MicrochipSecurityFG/Class_HackingTheBadge_2025/hw/KiCad_badge/Project KiCAD/Keystone/596.step

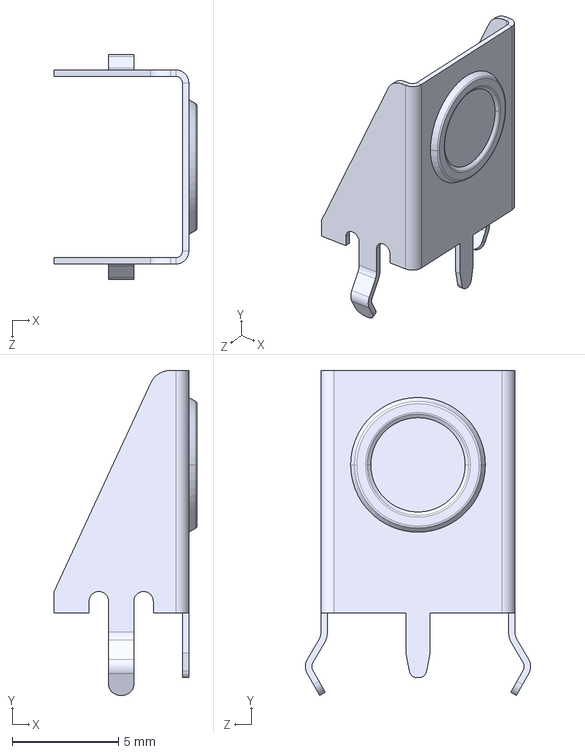
[picture p1: CAD file, 2025-06-12]
hw/KiCad_badge/Project KiCAD/Keystone/596.step
6.73 x 15.3 x 10.6 mm
