MicrochipSecurityFG/Class_HackingTheBadge_2025/hw/KiCad_badge/Project KiCAD/Keystone/590--3DModel-STEP-630548.STEP

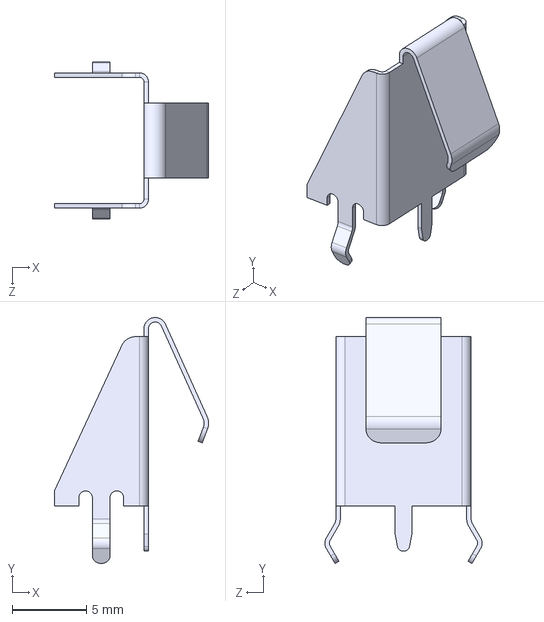
[picture p2: CAD file, 2025-06-12]
hw/KiCad_badge/Project KiCAD/Keystone/590--3DModel-STEP-630548.STEP
10.4 x 16.6 x 10.6 mm
