MicrochipSecurityFG/Class_HackingTheBadge_2025/hw/KiCad_badge/Project KiCAD/misc/USB4105-GF-A.step

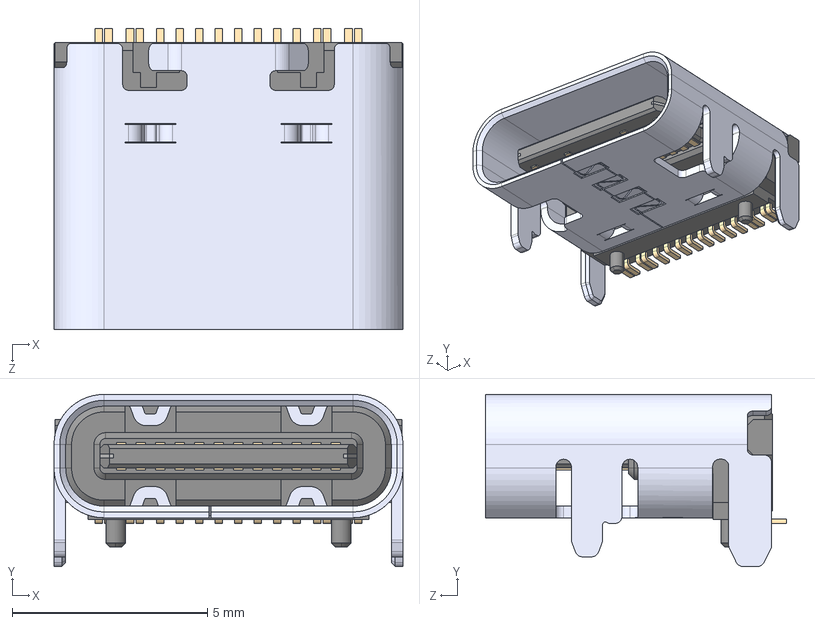
[picture p3: CAD file, 2025-06-12]
hw/KiCad_badge/Project KiCAD/misc/USB4105-GF-A.step
8.94 x 4.41 x 7.71 mm
