MicrochipSecurityFG/Class_HackingTheBadge_2025/hw/KiCad_badge/Project KiCAD/misc/RM100--3DModel-STEP-56544.STEP

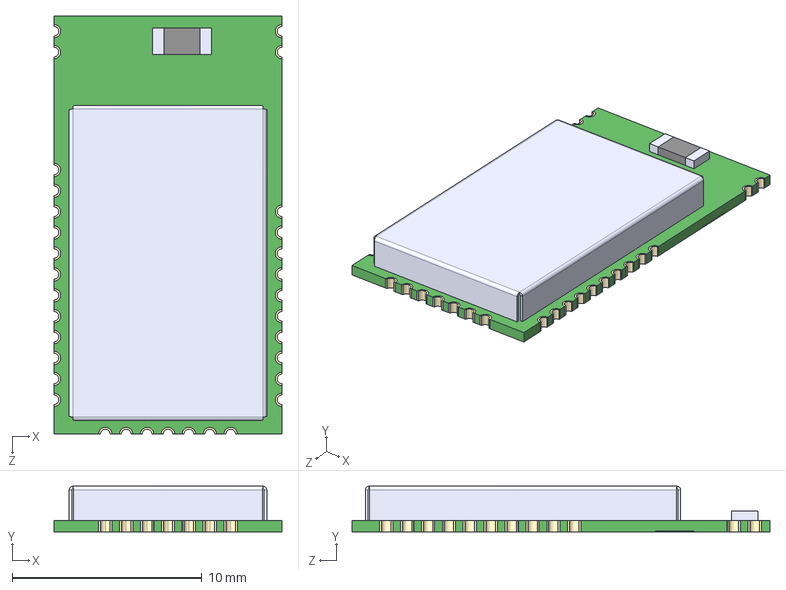
[picture p4: CAD file, 2025-06-12]
hw/KiCad_badge/Project KiCAD/misc/RM100--3DModel-STEP-56544.STEP
12.0 x 2.40 x 22.0 mm
