MicrochipSecurityFG/Class_HackingTheBadge_2025/hw/KiCad_badge/Project KiCAD/misc/AAA Battery.stp

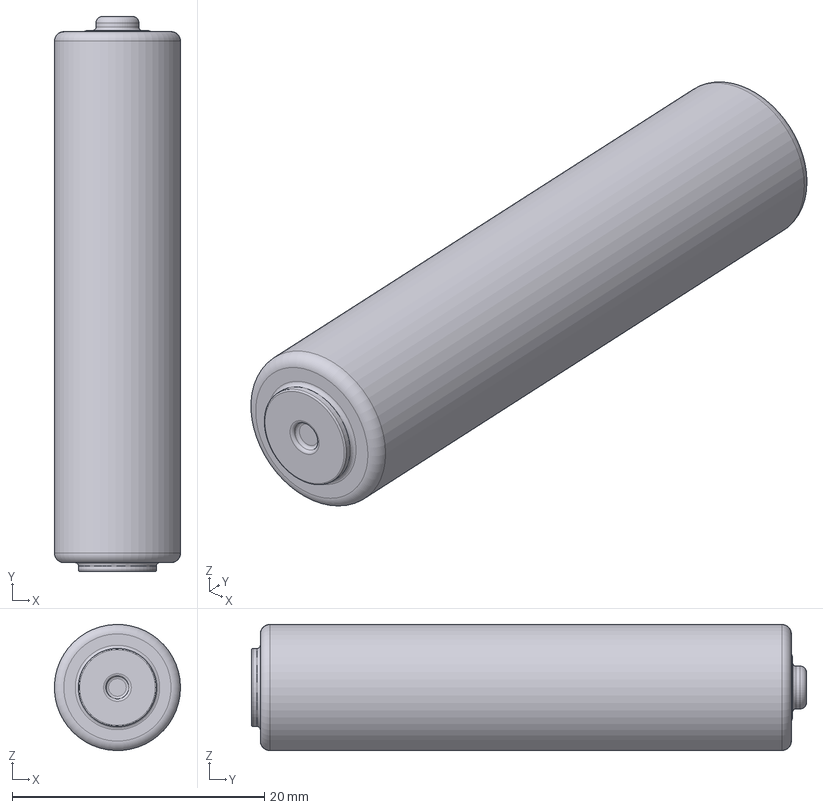
[picture p5: CAD file, 2025-06-12]
hw/KiCad_badge/Project KiCAD/misc/AAA Battery.stp
9.99 x 44.0 x 10.00 mm
