MicrochipSecurityFG/Class_HackingTheBadge_2025/hw/KiCad_badge/Project KiCAD/misc/47571-0001-with-sdcard.STEP

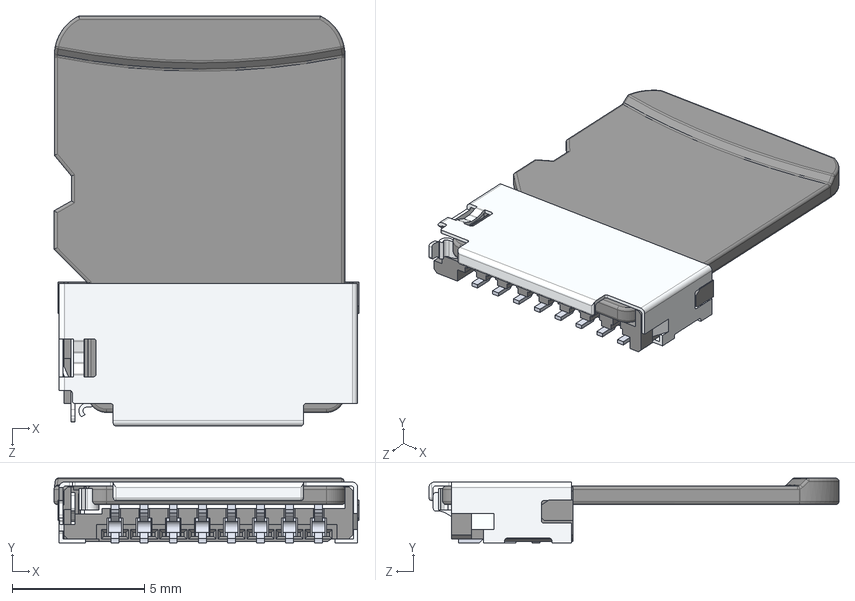
[picture p6: CAD file, 2025-06-12]
hw/KiCad_badge/Project KiCAD/misc/47571-0001-with-sdcard.STEP
11.5 x 2.45 x 15.5 mm
microsd
