MicrochipSecurityFG/Class_HackingTheBadge_2025/hw/KiCad_badge/Project KiCAD/misc/47571-0001.STEP

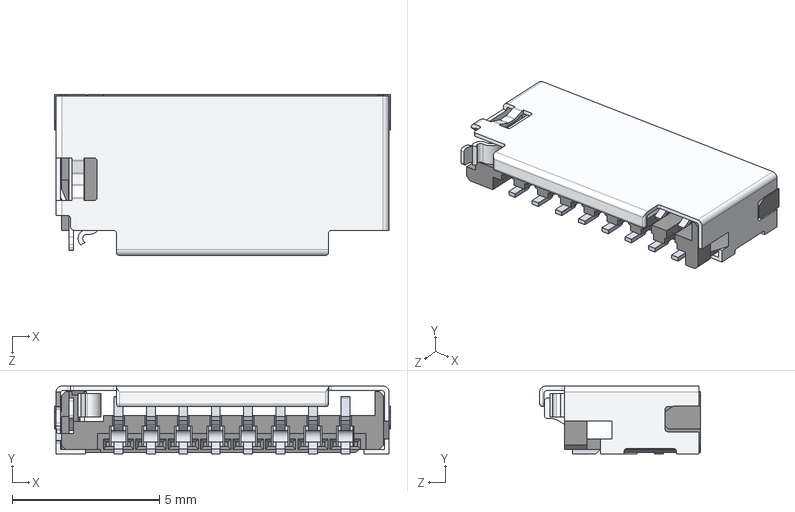
[picture p7: CAD file, 2025-06-12]
hw/KiCad_badge/Project KiCAD/misc/47571-0001.STEP
11.4 x 2.30 x 5.45 mm
