MicrochipSecurityFG/Class_HackingTheBadge_2025/doc/schematic.pdf

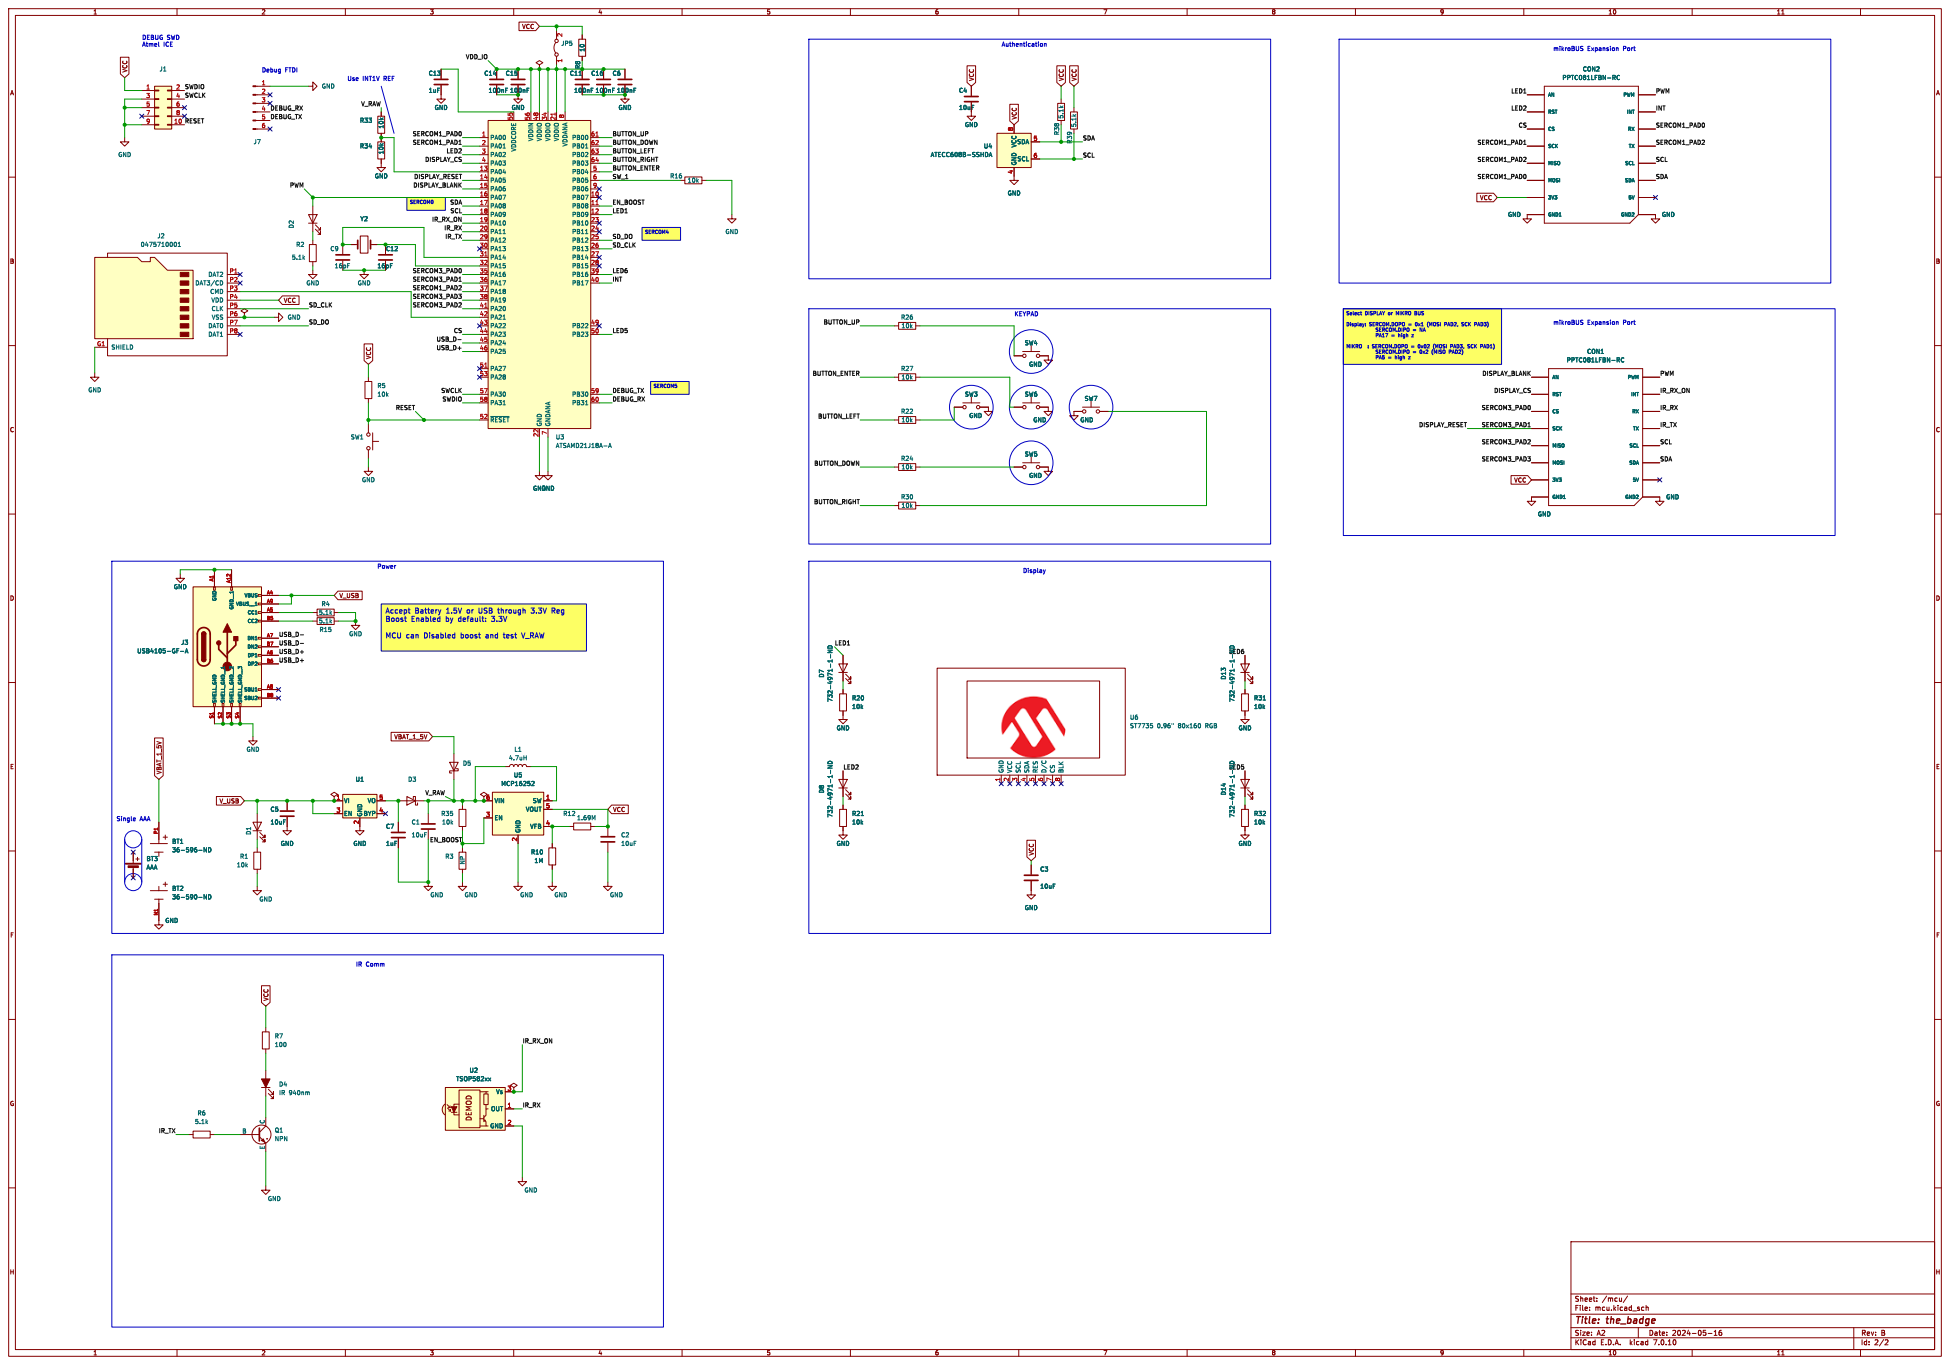
[picture p8: page 1]

mikroBUS Expansion Port KEYPAD

File: mcu.kicad_sch Sheet: /mcu/ 1

10k GND GND GND GND
