MicrochipSecurityFG/Class_HackingTheBadge_2025/sw/pc/TERATERM.INI

[Tera Term]
Version=4.106
Language=English
Port=serial
TerminalSize=113,61
TermIsWin=on
AutoWinResize=off
CRReceive=LF
CRSend=LF
LocalEcho=on
Answerback=
KanjiReceive=SJIS
KatakanaReceive=8
KanjiSend=SJIS
KatakanaSend=8
KanjiIn=B
KanjiOut=J
ConnectingTimeout=0
DisablePasteMouseRButton=off
DisablePasteMouseMButton=on
ConfirmPasteMouseRButton=off
ConfirmChangePaste=on
ConfirmChangePasteCR=on
ConfirmChangePasteStringFile=
ScrollWindowClearScreen=on
SelectOnlyByLButton=on
DisableAcceleratorSendBreak=off
EnableContinuedLineCopy=on
MouseCursor=IBEAM
AlphaBlend=255
AlphaBlendActive=255
CygwinDirectory=c:\cygwin
ViewlogEditor=C:\windows\notepad.exe
Locale=japanese
ANSIColor=0,0,0,0, 1,255,0,0, 2,0,255,0, 3,255,255,0, 4,0,0,255, 5,255,0,255, 6,0,255,255, 7,255,255,255, 8,128,128,128, 9,128,0,0, 10,0,128,0, 11,128,128,0, 12,0,0,128, 13,128,0,128, 14,0,128,128, 15,192,192,192
AutoWinSwitch=off
TerminalID=VT100
RussHost=KOI8-R
RussClient=Windows
Title=Tera Term
CursorShape=block
HideTitle=off
PopupMenu=off
PcBoldColor=off
Aixterm16Color=off
Xterm256Color=on
EnableScrollBuff=on
ScrollBuffSize=1000
VTColor=255,255,255,0,0,0
VTBoldColor=0,0,255,255,255,255
VTBlinkColor=255,0,0,255,255,255
VTReverseColor=255,255,255,0,0,0
EnableClickableUrl=off
URLColor=0,255,0,255,255,255
EnableBoldAttrColor=on
EnableBlinkAttrColor=on
EnableReverseAttrColor=off
EnableURLColor=on
URLUnderline=on
EnableANSIColor=on
TEKColor=0,0,0,255,255,255
TEKColorEmulation=off
VTFont=Terminal,0,-13,1
EnableBold=on
RussFont=Windows
TEKFont=Courier,0,-13,0
BSKey=BS
DeleteKey=off
Metakey=off
DisableAppKeypad=off
DisableAppCursor=off
RussKeyb=Windows
ComPort=3
BaudRate=115200
Parity=none
DataBit=8
StopBit=1
FlowCtrl=none
DelayPerChar=0
DelayPerLine=0
Telnet=on
TermType=xterm
TCPPort=23
AutoWinClose=on
Historylist=off
TransBin=off
LogBinary=off
LogAppend=off
LogTypePlainText=off
LogTimestamp=off
LogHideDialog=off
LogIncludeScreenBuffer=off
LogTimestampFormat=%Y-%m-%d %H:%M:%S.%N
LogTimestampType=Local
LogDefaultName=teraterm.log
LogDefaultPath=
LogAutoStart=off
LogRotate=0
LogRotateSize=0
LogRotateSizeType=0
LogRotateStep=0
DeferredLogWriteMode=on
XmodemOpt=checksum
XmodemBin=on
XmodemRcvCommand=
FileDir=C:\Users\c40249\Downloads
FileSendFilter=
ScpSendDir=
Accept8BitCtrl=on
AllowWrongSequence=off
AutoComPortReconnect=on
AutoFileRename=off
AutoTextCopy=on
BackWrap=off
Beep=on
BeepOnConnect=off
BPAuto=off
BPEscCtl=off
BPLog=off
ClearComBuffOnOpen=on
WaitCom=off
ConfirmDisconnect=on
CtrlInKanji=on
Debug=off
DelimList=$20!"#$24%&'()*+,-./:;<=>?@[\]^`{|}~
DelimDBCS=on
EnablePopupMenu=on
EnableShowMenu=on
EnableStatusLine=on
FileSendHighSpeedMode=on
IME=on
IMEInline=on
KmtLog=off
KmtLongPacket=off
KmtFileAttr=off
LanguageSelection=on
MaxBuffSize=10000
MaxComPort=256
NonblinkingCursor=off
KillFocusCursor=on
PassThruDelay=3
PassThruPort=
PrinterCtrlSequence=on
PrnFont=
PrnMargin=50,50,50,50
PrnConvFF=off
QVLog=off
QVWinSize=8
RussPrint=Windows
ScrollThreshold=12
MouseWheelScrollLine=3
SelectOnActivate=on
Send8BitCtrl=off
SendBreakTime=1000
StartupMacro=
TEKGINMouseCode=32
TelAutoDetect=on
TelBin=off
TelEcho=off
TelLog=off
TelPort=23
TelKeepAliveInterval=300
MaxBroadcatHistory=99
TCPLocalEcho=off
TCPCRSend=
UseTextColor=off
TitleFormat=13
VTCompatTab=off
VTFontSpace=0,0,0,0
VTPPI=0,0
TEKPPI=0,0
WindowMenu=on
XmodemLog=off
YmodemLog=off
YmodemRcvCommand=rb
ZmodemAuto=off
ZmodemDataLen=1024
ZmodemWinSize=32767
ZmodemEscCtl=off
ZmodemLog=off
ZmodemRcvCommand=rz
UseNormalBGColor=off
UILanguageFile=lang\Default.lng
BroadcastCommandHistory=off
AcceptBroadcast=on
ConfirmFileDragAndDrop=on
TranslateWheelToCursor=on
HostDialogOnStartup=on
MouseEventTracking=on
MaximizedBugTweak=2
UnicodeToDecSpMapping=3
AutoScrollOnlyInBottomLine=off
UnknownUnicodeCharacterAsWide=off
AcceptTitleChangeRequest=overwrite
PasteDialogSize=448,303
DisableMouseTrackingByCtrl=on
DisableWheelToCursorByCtrl=on
StrictKeyMapping=off
Wait4allMacroCommand=off
DisableMenuSendBreak=off
ClearScreenOnCloseConnection=off
DisableAcceleratorDuplicateSession=off
AcceleratorNewConnection=on
AcceleratorCygwinConnection=on
DisableMenuDuplicateSession=off
DisableMenuNewConnection=off
PasteDelayPerLine=10
Meta8Bit=off
WindowCtrlSequence=on
CursorCtrlSequence=off
WindowReportSequence=on
TitleReportSequence=empty
EnableLineMode=on
ClearOnResize=on
AlternateScreenBuffer=on
IMERelatedCursor=off
TerminalUID=FFFFFFFF
LockTUID=on
JumpList=on
TabStopModifySequence=on
ClipboardAccessFromRemote=off
NotifyClipboardAccess=on
ClickableUrlBrowser=
ClickableUrlBrowserArg=
LogLockExclusive=on
FontQuality=default
BeepOverUsedCount=5
BeepOverUsedTime=2
BeepSuppressTime=5
MaxOSCBufferSize=4096
JoinSplitURL=off
JoinSplitURLIgnoreEOLChar=\
DebugModes=all
XmodemTimeouts=10,3,10,20,60
YmodemTimeouts=10,3,10,20,60
ZmodemTimeouts=10,0,10,3
TrimTrailingNLonPaste=on
NormalizeLineBreakOnPaste=off
ListHiddenFonts=off
ISO2022ShiftFunction=on
TerminalSpeed=38400
ClearScrollBufferFromRemote=off
MouseSelectStartDelay=0
DlgFont=,0,0
[BG]
BGEnable=off
BGUseAlphaBlendAPI=on
BGSPIPath=plugin
BGFastSizeMove=on
BGFlickerlessMove=on
BGNoFrame=off
BGThemeFile=
BGIgnoreThemeFile=off
[TTSSH]
Enabled=0
Compression=0
DefaultUserType=1
DefaultUserName=
DefaultForwarding=
CipherOrder=MKN>H:J=G9LI<F8C7D;EB30A@?62
KexOrder=567:9843210
HostKeyOrder=4567230
MacOrder=@?:861>5;20<=34
CompOrder=3210
KnownHostsFiles=ssh_known_hosts
DefaultRhostsLocalUserName=
DefaultRhostsHostPrivateKeyFile=
DefaultRSAPrivateKeyFile=
DefaultAuthMethod=3
LogLevel=0
WriteBufferSize=2097152
ProtocolVersion=2
HeartBeat=60
RememberPassword=1
CheckAuthListFirst=0
EnableRsaShortKeyServer=0
ForwardAgent=0
ForwardAgentConfirm=1
ForwardAgentNotify=1
VerifyHostKeyDNS=1
SSHIcon=Default
DisablePopupMessage=0
X11Display=
UpdateHostkeys=0
GexMinimalGroupSize=0
AuthBanner=1
[TTProxy]
ConnectionTimeout="10"
SocksResolve="auto"
TelnetHostnamePrompt=">> Host name: "
TelnetUsernamePrompt="Username:"
TelnetPasswordPrompt="Password:"
TelnetConnectedMessage="-- Connected to "
TelnetErrorMessage="!!!!!!!!"
[Hosts]
Host1=192.168.1.20
