MicrochipSecurityFG/Class_HackingTheBadge_2025/sw/wallet_firmware/firmware/src/config/default/configuration.h

/*******************************************************************************
  System Configuration Header

  File Name:
    configuration.h

  Summary:
    Build-time configuration header for the system defined by this project.

  Description:
    An MPLAB Project may have multiple configurations.  This file defines the
    build-time options for a single configuration.

  Remarks:
    This configuration header must not define any prototypes or data
    definitions (or include any files that do).  It only provides macro
    definitions for build-time configuration options

*******************************************************************************/

// DOM-IGNORE-BEGIN
/*******************************************************************************
* Copyright (C) 2018 Microchip Technology Inc. and its subsidiaries.
*
* Subject to your compliance with these terms, you may use Microchip software
* and any derivatives exclusively with Microchip products. It is your
* responsibility to comply with third party license terms applicable to your
* use of third party software (including open source software) that may
* accompany Microchip software.
*
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
* IN NO EVENT WILL MICROCHIP BE LIABLE FOR ANY INDIRECT, SPECIAL, PUNITIVE,
* INCIDENTAL OR CONSEQUENTIAL LOSS, DAMAGE, COST OR EXPENSE OF ANY KIND
* WHATSOEVER RELATED TO THE SOFTWARE, HOWEVER CAUSED, EVEN IF MICROCHIP HAS
* BEEN ADVISED OF THE POSSIBILITY OR THE DAMAGES ARE FORESEEABLE. TO THE
* FULLEST EXTENT ALLOWED BY LAW, MICROCHIP'S TOTAL LIABILITY ON ALL CLAIMS IN
* ANY WAY RELATED TO THIS SOFTWARE WILL NOT EXCEED THE AMOUNT OF FEES, IF ANY,
* THAT YOU HAVE PAID DIRECTLY TO MICROCHIP FOR THIS SOFTWARE.
*******************************************************************************/
// DOM-IGNORE-END

#ifndef CONFIGURATION_H
#define CONFIGURATION_H

// *****************************************************************************
// *****************************************************************************
// Section: Included Files
// *****************************************************************************
// *****************************************************************************
/*  This section Includes other configuration headers necessary to completely
    define this configuration.
*/

#include "user.h"
#include "device.h"

// DOM-IGNORE-BEGIN
#ifdef __cplusplus  // Provide C++ Compatibility

extern "C" {

#endif
// DOM-IGNORE-END

// *****************************************************************************
// *****************************************************************************
// Section: System Configuration
// *****************************************************************************
// *****************************************************************************



// *****************************************************************************
// *****************************************************************************
// Section: System Service Configuration
// *****************************************************************************
// *****************************************************************************
/* TIME System Service Configuration Options */
#define SYS_TIME_INDEX_0                            (0)
#define SYS_TIME_MAX_TIMERS                         (5)
#define SYS_TIME_HW_COUNTER_WIDTH                   (16)
#define SYS_TIME_HW_COUNTER_PERIOD                  (0xFFFFU)
#define SYS_TIME_HW_COUNTER_HALF_PERIOD             (SYS_TIME_HW_COUNTER_PERIOD>>1)
#define SYS_TIME_CPU_CLOCK_FREQUENCY                (48000000)
#define SYS_TIME_COMPARE_UPDATE_EXECUTION_CYCLES    (200)



// *****************************************************************************
// *****************************************************************************
// Section: Driver Configuration
// *****************************************************************************
// *****************************************************************************
/* SPI Driver Common Configuration Options */
#define DRV_SPI_INSTANCES_NUMBER              (1U)

/* SPI Driver Instance 0 Configuration Options */
#define DRV_SPI_INDEX_0                       0
#define DRV_SPI_CLIENTS_NUMBER_IDX0           1
#define DRV_SPI_QUEUE_SIZE_IDX0               8



// *****************************************************************************
// *****************************************************************************
// Section: Middleware & Other Library Configuration
// *****************************************************************************
// *****************************************************************************


// *****************************************************************************
// *****************************************************************************
// Section: Application Configuration
// *****************************************************************************
// *****************************************************************************


//DOM-IGNORE-BEGIN
#ifdef __cplusplus
}
#endif
//DOM-IGNORE-END

#endif // CONFIGURATION_H
/*******************************************************************************
 End of File
*/
