MicrochipSecurityFG/Class_HackingTheBadge_2025/sw/wallet_firmware/firmware/src/config/default/initialization.c

/*******************************************************************************
  System Initialization File

  File Name:
    initialization.c

  Summary:
    This file contains source code necessary to initialize the system.

  Description:
    This file contains source code necessary to initialize the system.  It
    implements the "SYS_Initialize" function, defines the configuration bits,
    and allocates any necessary global system resources,
 *******************************************************************************/

// DOM-IGNORE-BEGIN
/*******************************************************************************
* Copyright (C) 2018 Microchip Technology Inc. and its subsidiaries.
*
* Subject to your compliance with these terms, you may use Microchip software
* and any derivatives exclusively with Microchip products. It is your
* responsibility to comply with third party license terms applicable to your
* use of third party software (including open source software) that may
* accompany Microchip software.
*
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
* IN NO EVENT WILL MICROCHIP BE LIABLE FOR ANY INDIRECT, SPECIAL, PUNITIVE,
* INCIDENTAL OR CONSEQUENTIAL LOSS, DAMAGE, COST OR EXPENSE OF ANY KIND
* WHATSOEVER RELATED TO THE SOFTWARE, HOWEVER CAUSED, EVEN IF MICROCHIP HAS
* BEEN ADVISED OF THE POSSIBILITY OR THE DAMAGES ARE FORESEEABLE. TO THE
* FULLEST EXTENT ALLOWED BY LAW, MICROCHIP'S TOTAL LIABILITY ON ALL CLAIMS IN
* ANY WAY RELATED TO THIS SOFTWARE WILL NOT EXCEED THE AMOUNT OF FEES, IF ANY,
* THAT YOU HAVE PAID DIRECTLY TO MICROCHIP FOR THIS SOFTWARE.
 *******************************************************************************/
// DOM-IGNORE-END

// *****************************************************************************
// *****************************************************************************
// Section: Included Files
// *****************************************************************************
// *****************************************************************************
#include "configuration.h"
#include "definitions.h"
#include "device.h"


// ****************************************************************************
// ****************************************************************************
// Section: Configuration Bits
// ****************************************************************************
// ****************************************************************************
#pragma config NVMCTRL_BOOTPROT = SIZE_0BYTES
#pragma config NVMCTRL_EEPROM_SIZE = SIZE_0BYTES
#pragma config BOD33USERLEVEL = 0x7U // Enter Hexadecimal value
#pragma config BOD33_EN = ENABLED
#pragma config BOD33_ACTION = RESET

#pragma config BOD33_HYST = DISABLED
#pragma config NVMCTRL_REGION_LOCKS = 0xffffU // Enter Hexadecimal value

#pragma config WDT_ENABLE = DISABLED
#pragma config WDT_ALWAYSON = DISABLED
#pragma config WDT_PER = CYC16384

#pragma config WDT_WINDOW_0 = SET
#pragma config WDT_WINDOW_1 = 0x4U // Enter Hexadecimal value
#pragma config WDT_EWOFFSET = CYC16384
#pragma config WDT_WEN = DISABLED




// *****************************************************************************
// *****************************************************************************
// Section: Driver Initialization Data
// *****************************************************************************
// *****************************************************************************
/* Following MISRA-C rules are deviated in the below code block */
/* MISRA C-2012 Rule 11.1 */
/* MISRA C-2012 Rule 11.3 */
/* MISRA C-2012 Rule 11.8 */
// <editor-fold defaultstate="collapsed" desc="DRV_SPI Instance 0 Initialization Data">

/* SPI Client Objects Pool */
static DRV_SPI_CLIENT_OBJ drvSPI0ClientObjPool[DRV_SPI_CLIENTS_NUMBER_IDX0];

/* SPI Transfer Objects Pool */
static DRV_SPI_TRANSFER_OBJ drvSPI0TransferObjPool[DRV_SPI_QUEUE_SIZE_IDX0];

/* SPI PLIB Interface Initialization */
static const DRV_SPI_PLIB_INTERFACE drvSPI0PlibAPI = {

    /* SPI PLIB Setup */
    .setup = (DRV_SPI_PLIB_SETUP)SERCOM3_SPI_TransferSetup,

    /* SPI PLIB WriteRead function */
    .writeRead = (DRV_SPI_PLIB_WRITE_READ)SERCOM3_SPI_WriteRead,

    /* SPI PLIB Transfer Status function */
    .isTransmitterBusy = (DRV_SPI_PLIB_TRANSMITTER_IS_BUSY)SERCOM3_SPI_IsTransmitterBusy,

    /* SPI PLIB Callback Register */
    .callbackRegister = (DRV_SPI_PLIB_CALLBACK_REGISTER)SERCOM3_SPI_CallbackRegister,
};

static const uint32_t drvSPI0remapDataBits[]= { 0x0, 0x1, 0xFFFFFFFFU, 0xFFFFFFFFU, 0xFFFFFFFFU, 0xFFFFFFFFU, 0xFFFFFFFFU, 0xFFFFFFFFU, 0xFFFFFFFFU, 0xFFFFFFFFU };
static const uint32_t drvSPI0remapClockPolarity[] = { 0x0, 0x20000000 };
static const uint32_t drvSPI0remapClockPhase[] = { 0x10000000, 0x0 };

static const DRV_SPI_INTERRUPT_SOURCES drvSPI0InterruptSources =
{
    /* Peripheral has single interrupt vector */
    .isSingleIntSrc                        = true,

    /* Peripheral interrupt line */
    .intSources.spiInterrupt             = (int32_t)SERCOM3_IRQn,
};

/* SPI Driver Initialization Data */
static const DRV_SPI_INIT drvSPI0InitData =
{
    /* SPI PLIB API */
    .spiPlib = &drvSPI0PlibAPI,

    .remapDataBits = drvSPI0remapDataBits,

    .remapClockPolarity = drvSPI0remapClockPolarity,

    .remapClockPhase = drvSPI0remapClockPhase,

    /* SPI Number of clients */
    .numClients = DRV_SPI_CLIENTS_NUMBER_IDX0,

    /* SPI Client Objects Pool */
    .clientObjPool = (uintptr_t)&drvSPI0ClientObjPool[0],


    /* SPI Queue Size */
    .transferObjPoolSize = DRV_SPI_QUEUE_SIZE_IDX0,

    /* SPI Transfer Objects Pool */
    .transferObjPool = (uintptr_t)&drvSPI0TransferObjPool[0],

    /* SPI interrupt sources (SPI peripheral and DMA) */
    .interruptSources = &drvSPI0InterruptSources,
};
// </editor-fold>



// *****************************************************************************
// *****************************************************************************
// Section: System Data
// *****************************************************************************
// *****************************************************************************
/* Structure to hold the object handles for the modules in the system. */
SYSTEM_OBJECTS sysObj;

// *****************************************************************************
// *****************************************************************************
// Section: Library/Stack Initialization Data
// *****************************************************************************
// *****************************************************************************


// *****************************************************************************
// *****************************************************************************
// Section: System Initialization
// *****************************************************************************
// *****************************************************************************
// <editor-fold defaultstate="collapsed" desc="SYS_TIME Initialization Data">

static const SYS_TIME_PLIB_INTERFACE sysTimePlibAPI = {
    .timerCallbackSet = (SYS_TIME_PLIB_CALLBACK_REGISTER)TC3_TimerCallbackRegister,
    .timerStart = (SYS_TIME_PLIB_START)TC3_TimerStart,
    .timerStop = (SYS_TIME_PLIB_STOP)TC3_TimerStop,
    .timerFrequencyGet = (SYS_TIME_PLIB_FREQUENCY_GET)TC3_TimerFrequencyGet,
    .timerPeriodSet = (SYS_TIME_PLIB_PERIOD_SET)TC3_Timer16bitPeriodSet,
    .timerCompareSet = (SYS_TIME_PLIB_COMPARE_SET)TC3_Timer16bitCompareSet,
    .timerCounterGet = (SYS_TIME_PLIB_COUNTER_GET)TC3_Timer16bitCounterGet,
};

static const SYS_TIME_INIT sysTimeInitData =
{
    .timePlib = &sysTimePlibAPI,
    .hwTimerIntNum = TC3_IRQn,
};

// </editor-fold>



// *****************************************************************************
// *****************************************************************************
// Section: Local initialization functions
// *****************************************************************************
// *****************************************************************************


/* MISRAC 2012 deviation block end */

/*******************************************************************************
  Function:
    void SYS_Initialize ( void *data )

  Summary:
    Initializes the board, services, drivers, application and other modules.

  Remarks:
 */

void SYS_Initialize ( void* data )
{

    /* MISRAC 2012 deviation block start */
    /* MISRA C-2012 Rule 2.2 deviated in this file.  Deviation record ID -  H3_MISRAC_2012_R_2_2_DR_1 */

    NVMCTRL_REGS->NVMCTRL_CTRLB = NVMCTRL_CTRLB_RWS(3UL);


  
    PORT_Initialize();

    CLOCK_Initialize();




    NVMCTRL_Initialize( );

    TC3_TimerInitialize();

    TC4_TimerInitialize();

    SERCOM3_SPI_Initialize();

    SERCOM2_USART_Initialize();


    SERCOM0_I2C_Initialize();

	SYSTICK_TimerInitialize();
    SERCOM5_USART_Initialize();

    EIC_Initialize();

    TCC2_PWMInitialize();



    /* MISRAC 2012 deviation block start */
    /* Following MISRA-C rules deviated in this block  */
    /* MISRA C-2012 Rule 11.3 - Deviation record ID - H3_MISRAC_2012_R_11_3_DR_1 */
    /* MISRA C-2012 Rule 11.8 - Deviation record ID - H3_MISRAC_2012_R_11_8_DR_1 */

    /* Initialize SPI0 Driver Instance */
    sysObj.drvSPI0 = DRV_SPI_Initialize(DRV_SPI_INDEX_0, (SYS_MODULE_INIT *)&drvSPI0InitData);

    DRV_ST7735S_Initialize();


    /* MISRA C-2012 Rule 11.3, 11.8 deviated below. Deviation record ID -  
    H3_MISRAC_2012_R_11_3_DR_1 & H3_MISRAC_2012_R_11_8_DR_1*/
        
    sysObj.sysTime = SYS_TIME_Initialize(SYS_TIME_INDEX_0, (SYS_MODULE_INIT *)&sysTimeInitData);
    
    /* MISRAC 2012 deviation block end */

    // initialize UI library
    Legato_Initialize();


    /* MISRAC 2012 deviation block end */
    APP_Initialize();


    NVIC_Initialize();


    /* MISRAC 2012 deviation block end */
}

/*******************************************************************************
 End of File
*/
