MicrochipSecurityFG/Class_HackingTheBadge_2025/sw/wallet_firmware/firmware/src/config/default/peripheral/eic/plib_eic.c

/*******************************************************************************
  External Interrupt Controller (EIC) PLIB

  Company
    Microchip Technology Inc.

  File Name
    plib_eic.c

  Summary
    Source for EIC peripheral library interface Implementation.

  Description
    This file defines the interface to the EIC peripheral library. This
    library provides access to and control of the associated peripheral
    instance.

  Remarks:
    None.

*******************************************************************************/

// DOM-IGNORE-BEGIN
/*******************************************************************************
* Copyright (C) 2018 Microchip Technology Inc. and its subsidiaries.
*
* Subject to your compliance with these terms, you may use Microchip software
* and any derivatives exclusively with Microchip products. It is your
* responsibility to comply with third party license terms applicable to your
* use of third party software (including open source software) that may
* accompany Microchip software.
*
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
* IN NO EVENT WILL MICROCHIP BE LIABLE FOR ANY INDIRECT, SPECIAL, PUNITIVE,
* INCIDENTAL OR CONSEQUENTIAL LOSS, DAMAGE, COST OR EXPENSE OF ANY KIND
* WHATSOEVER RELATED TO THE SOFTWARE, HOWEVER CAUSED, EVEN IF MICROCHIP HAS
* BEEN ADVISED OF THE POSSIBILITY OR THE DAMAGES ARE FORESEEABLE. TO THE
* FULLEST EXTENT ALLOWED BY LAW, MICROCHIP'S TOTAL LIABILITY ON ALL CLAIMS IN
* ANY WAY RELATED TO THIS SOFTWARE WILL NOT EXCEED THE AMOUNT OF FEES, IF ANY,
* THAT YOU HAVE PAID DIRECTLY TO MICROCHIP FOR THIS SOFTWARE.
*******************************************************************************/
// DOM-IGNORE-END

// *****************************************************************************
// *****************************************************************************
// Section: Included Files
// *****************************************************************************
// *****************************************************************************
/* This section lists the other files that are included in this file.
*/

#include "plib_eic.h"
#include "interrupts.h"

// *****************************************************************************
// *****************************************************************************
// Section: Global Data
// *****************************************************************************
// *****************************************************************************
/* EIC Channel Callback object */
volatile static EIC_CALLBACK_OBJ    eicCallbackObject[EXTINT_COUNT];


void EIC_Initialize(void)
{
    /* Reset all registers in the EIC module to their initial state and
       EIC will be disabled. */
    EIC_REGS->EIC_CTRL |= EIC_CTRL_SWRST_Msk;

    while((EIC_REGS->EIC_STATUS & EIC_STATUS_SYNCBUSY_Msk) == EIC_STATUS_SYNCBUSY_Msk)
    {
        /* Wait for sync */
    }

    /* NMI Control register */

    /* Interrupt sense type and filter control for EXTINT channels 0 to 7 */
    EIC_REGS->EIC_CONFIG[0] = EIC_CONFIG_SENSE0_FALL | EIC_CONFIG_FILTEN0_Msk |
                              EIC_CONFIG_SENSE1_FALL | EIC_CONFIG_FILTEN1_Msk |
                              EIC_CONFIG_SENSE2_FALL | EIC_CONFIG_FILTEN2_Msk |
                              EIC_CONFIG_SENSE3_FALL | EIC_CONFIG_FILTEN3_Msk |
                              EIC_CONFIG_SENSE4_FALL | EIC_CONFIG_FILTEN4_Msk |
                              EIC_CONFIG_SENSE5_NONE  |
                              EIC_CONFIG_SENSE6_NONE  |
                              EIC_CONFIG_SENSE7_NONE ;

    /* Interrupt sense type and filter control for EXTINT channels 8 to 15 */
    EIC_REGS->EIC_CONFIG[1] = EIC_CONFIG_SENSE0_NONE  |
                              EIC_CONFIG_SENSE1_NONE  |
                              EIC_CONFIG_SENSE2_NONE  |
                              EIC_CONFIG_SENSE3_NONE  |
                              EIC_CONFIG_SENSE4_NONE  |
                              EIC_CONFIG_SENSE5_NONE  |
                              EIC_CONFIG_SENSE6_NONE  |
                              EIC_CONFIG_SENSE7_NONE ;

    /* External Interrupt enable*/
    EIC_REGS->EIC_INTENSET = 0x1f;

    /* Callbacks for enabled interrupts */
    eicCallbackObject[0].eicPinNo = EIC_PIN_0;
    eicCallbackObject[1].eicPinNo = EIC_PIN_1;
    eicCallbackObject[2].eicPinNo = EIC_PIN_2;
    eicCallbackObject[3].eicPinNo = EIC_PIN_3;
    eicCallbackObject[4].eicPinNo = EIC_PIN_4;
    eicCallbackObject[5].eicPinNo = EIC_PIN_MAX;
    eicCallbackObject[6].eicPinNo = EIC_PIN_MAX;
    eicCallbackObject[7].eicPinNo = EIC_PIN_MAX;
    eicCallbackObject[8].eicPinNo = EIC_PIN_MAX;
    eicCallbackObject[9].eicPinNo = EIC_PIN_MAX;
    eicCallbackObject[10].eicPinNo = EIC_PIN_MAX;
    eicCallbackObject[11].eicPinNo = EIC_PIN_MAX;
    eicCallbackObject[12].eicPinNo = EIC_PIN_MAX;
    eicCallbackObject[13].eicPinNo = EIC_PIN_MAX;
    eicCallbackObject[14].eicPinNo = EIC_PIN_MAX;
    eicCallbackObject[15].eicPinNo = EIC_PIN_MAX;

    /* Enable the EIC */
    EIC_REGS->EIC_CTRL |= EIC_CTRL_ENABLE_Msk;

    while((EIC_REGS->EIC_STATUS & EIC_STATUS_SYNCBUSY_Msk) == EIC_STATUS_SYNCBUSY_Msk)
    {
        /* Wait for sync */
    }
}

void EIC_InterruptEnable(EIC_PIN pin)
{
    EIC_REGS->EIC_INTENSET = (1UL << (uint32_t)pin);
}

void EIC_InterruptDisable(EIC_PIN pin)
{
    EIC_REGS->EIC_INTENCLR = (1UL << (uint32_t)pin);
}

void EIC_CallbackRegister(EIC_PIN pin, EIC_CALLBACK callback, uintptr_t context)
{
    if (eicCallbackObject[pin].eicPinNo == pin)
    {
        eicCallbackObject[pin].callback = callback;

        eicCallbackObject[pin].context  = context;
    }
}

void __attribute__((used)) EIC_InterruptHandler(void)
{
    uint8_t currentChannel;
    uint32_t eicIntFlagStatus;

    /* Find any triggered channels, run associated callback handlers */
    for (currentChannel = 0; currentChannel < EXTINT_COUNT; currentChannel++)
    {
        /* Verify if the EXTINT x Interrupt Pin is enabled */
        if (((uint8_t)eicCallbackObject[currentChannel].eicPinNo == currentChannel))
        {
            /* Read the interrupt flag status */
            eicIntFlagStatus = EIC_REGS->EIC_INTFLAG & (1UL << currentChannel);

            if (eicIntFlagStatus != 0U)
            {
                /* Find any associated callback entries in the callback table */
                if ((eicCallbackObject[currentChannel].callback != NULL))
                {
                    uintptr_t context = eicCallbackObject[currentChannel].context;
                    eicCallbackObject[currentChannel].callback(context);
                }

                /* Clear interrupt flag */
                EIC_REGS->EIC_INTFLAG = (1UL << currentChannel);
            }
        }
    }
}
