MicrochipSecurityFG/Class_HackingTheBadge_2025/sw/wallet_firmware/firmware/src/secure_element.h

/* ************************************************************************** */
/** Descriptive File Name

  @Company
    Company Name

  @File Name
    filename.h

  @Summary
    Brief description of the file.

  @Description
    Describe the purpose of this file.
 */
/* ************************************************************************** */

#ifndef _EXAMPLE_FILE_NAME_H    /* Guard against multiple inclusion */
#define _EXAMPLE_FILE_NAME_H

#include "cryptoauthlib.h"

extern const uint8_t mcu_key[];
extern ATCAIfaceCfg atecc608_0_init_data; //i2c

uint8_t SECURE_ELEMENT_WriteConfig(uint8_t addr);
void SECURE_ELEMENT_WriteData();
int SECURE_ELEMENT_WriteSlot8(const uint8_t *data, size_t length);
int SECURE_ELEMENT_ReadSlot8(uint8_t *data, size_t length);
int SECURE_ELEMENT_WriteSlot5(const uint8_t *data, size_t length);
int SECURE_ELEMENT_ReadSlot5(uint8_t *data, size_t length);
void SECURE_ELEMENT_GetRandom(uint8_t * random);
void SECURE_ELEMENT_GetSerial(uint8_t * serial);

#endif /* _EXAMPLE_FILE_NAME_H */

/* *****************************************************************************
 End of File
 */
