MicrochipSecurityFG/Class_HackingTheBadge_2025/(commit log)

2025-06-12 project init
    [47571-0001-with-sdcard.STEP, 47571-0001.STEP, 590--3DModel-STEP-630548.STEP, 590.step, 596--3DModel-STEP-630548.STEP, 596.step, AAA Battery.stp, RM100--3DModel-STEP-56544.STEP]
2025-07-09 adjusted to make glitch demo
    [ir.c, ir.h, main.c]
